ZAN-Tech-bd/fingerprint-access-control/docs/3d-models/enclosure-1-top-lid.stl

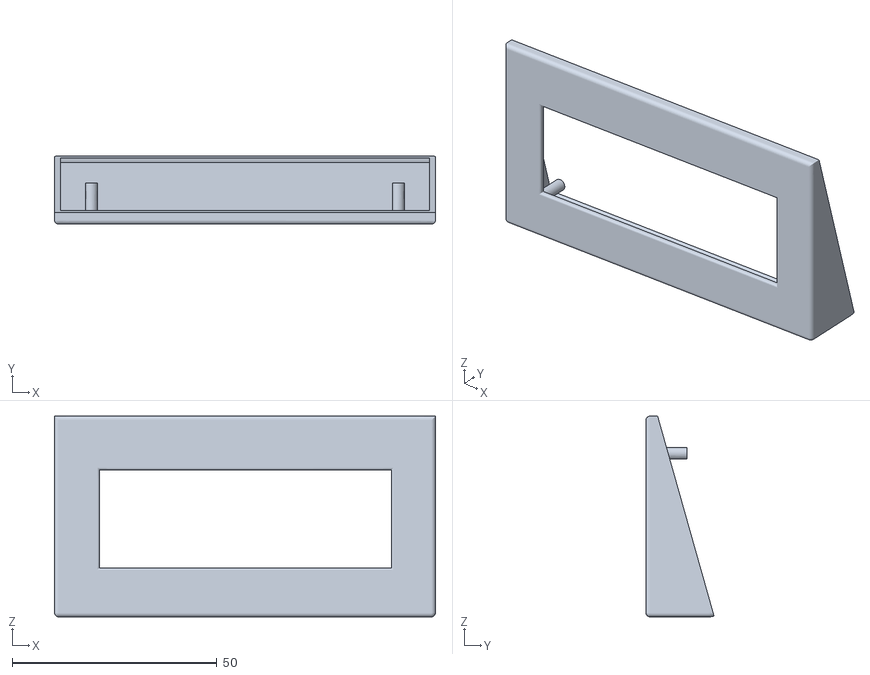
[picture p5: CAD file, 2026-10-27]
docs/3d-models/enclosure-1-top-lid.stl
93.0 x 16.6 x 49.0
