ZAN-Tech-bd/fingerprint-access-control/docs/3d-models/enclosure-3-lower-body.stl

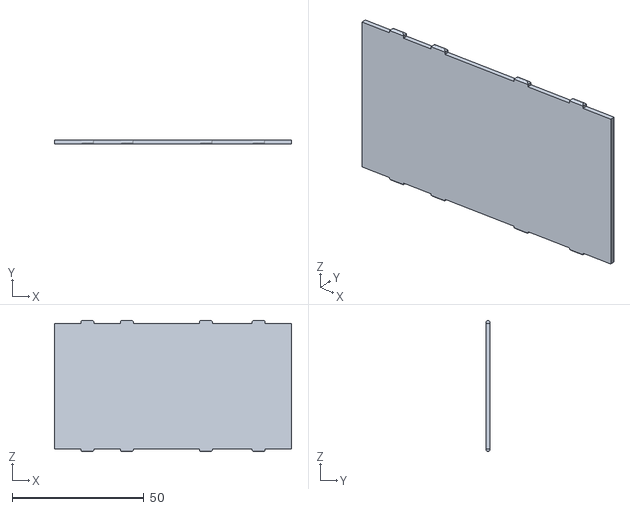
[picture p6: CAD file, 2026-10-27]
docs/3d-models/enclosure-3-lower-body.stl
90.0 x 1.50 x 49.9
