ZAN-Tech-bd/fingerprint-access-control/docs/3d-models/enclosure-2-middle-body.stl

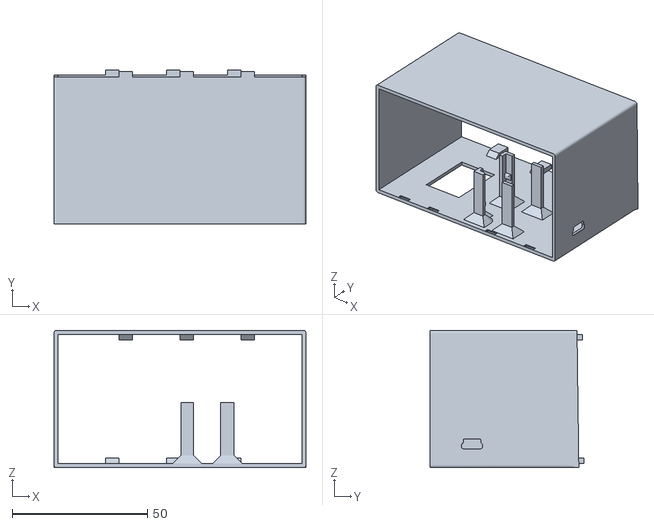
[picture p7: CAD file, 2026-10-27]
docs/3d-models/enclosure-2-middle-body.stl
93.0 x 57.0 x 50.7
