ZAN-Tech-bd/fingerprint-access-control/(commit log)

2026-10-27 Add initial implementation of fingerprint access control system
2026-10-27 Add fingerprint enrollment and common functionality
2026-10-27 Refactor code structure for improved readability and maintainability
    [enclosure-1-top-lid.stl, enclosure-2-middle-body.stl, enclosure-3-lower-body.stl]
